bnahill/audiopulse-embedded/(threads)

Thread 11 (2015-10-21):

Noise in analog input conditioning

bnahill, 2015-10-21:
A series of tests showed that a significant amount of input noise is coming from the analog conditioning.

The attached screenshot shows 3 distinct sets of samples. At the top (and consisting of a bunch of tests in slightly varying conditions) you can see normal samples with the microphone connected and isolated from acoustic noise sources. There is noise between 500 and 1000Hz. The series below that removes the microphone and shorts its terminals. Should that noise be at all related to the microphone or acoustic inputs, that noise should be eliminated. It isn't. To further verify, a final series at the bottom shows the result of shorting the terminals at the ADC.

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

Suggest working backwards through the input chain to identify the source of this. If it can't be identified, try to replicate with a different device.

bnahill, 2015-11-03:
The above tests were with a microphone with a low battery. The blue signal below was collected in a relatively noisy environment with a single 30dB channel at 2.2kHz:

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

The green signal highlights a different shortcoming: apparent clipping at moderate levels. The green signal was recorded with a single 60dB channel. The below was captured by an alternate source during the recording

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

The signals never approached bounds of the ADC, yet the distortion is apparent.

bnahill, 2015-11-03:
It looks like there's a decent chance the bug is in the digital parts again, which would be great.
A few options for next time re-visiting this:

1. Use current partial waveform dump capabilities to get a look at the raw data
2. Find a faster way (e.g., interrupt transfers) to dump raw waveforms to debug. This would be awesome for future stuff as well. The USB library must support this by now...
3. Trace the signals over the wire. This is probably the least work.

Thread 12 (2024-02-20):

Device tree for AK4621

xistva02, 2024-02-20:
Hello,

I have a specific question about the incorporation of AK4621. Did you use some kind of device tree configuration for the AK4621 chip? Is it available somewhere?

Thanks.

Matej I.

bnahill, 2024-03-17:
Matej,
I'm sorry it took so long to get back to you. I did not use a device tree for this--the various peripherals used to interact with the AK4621 were hard-coded into the software.
-Ben

xistva02, 2024-03-18:
Hey Ben, thank you for the reply.

I was wondering if you used the codec.cpp file (and other includes) as a machine codec for ALSA? It seems different from the classic audio machine codec driver structure. I found no support for ak4621 in official Linux codecs git: https://github.com/torvalds/linux/tree/master/sound/soc/codecs

My last question is, did you use your codec.cpp file as a machine driver or do you know any source that would provide a driver for ak4621?

Thanks.

Matej I.

bnahill, 2024-03-19:
Matej,
The AK4621 driver used in this project is actually a driver. It's just not one designed for Linux, where the various subcomponents (e.g., SPI and I2S) also need to conform to the Linux APIs for each (and support much broader use and configuration than I needed for this application, e.g., different sample rates and formats). If you're trying to add support to Linux, you have a driver to write. You can use this as a reference for the basics, but it is not a Linux driver.

That said, at the time, the AK4621 was an outstanding codec. I'm not sure what's come out since, but I would still recommend it based on my experience as long as it's still in production.
-Ben

xistva02, 2024-03-19:
Thank you, Ben.

Best regards

Matej I.

Closed 2024-03-19.
