bnahill/audiopulse-embedded/hw/doc/Kinetis K20 QFP64 Mechanical - 98ASS23234W.pdf

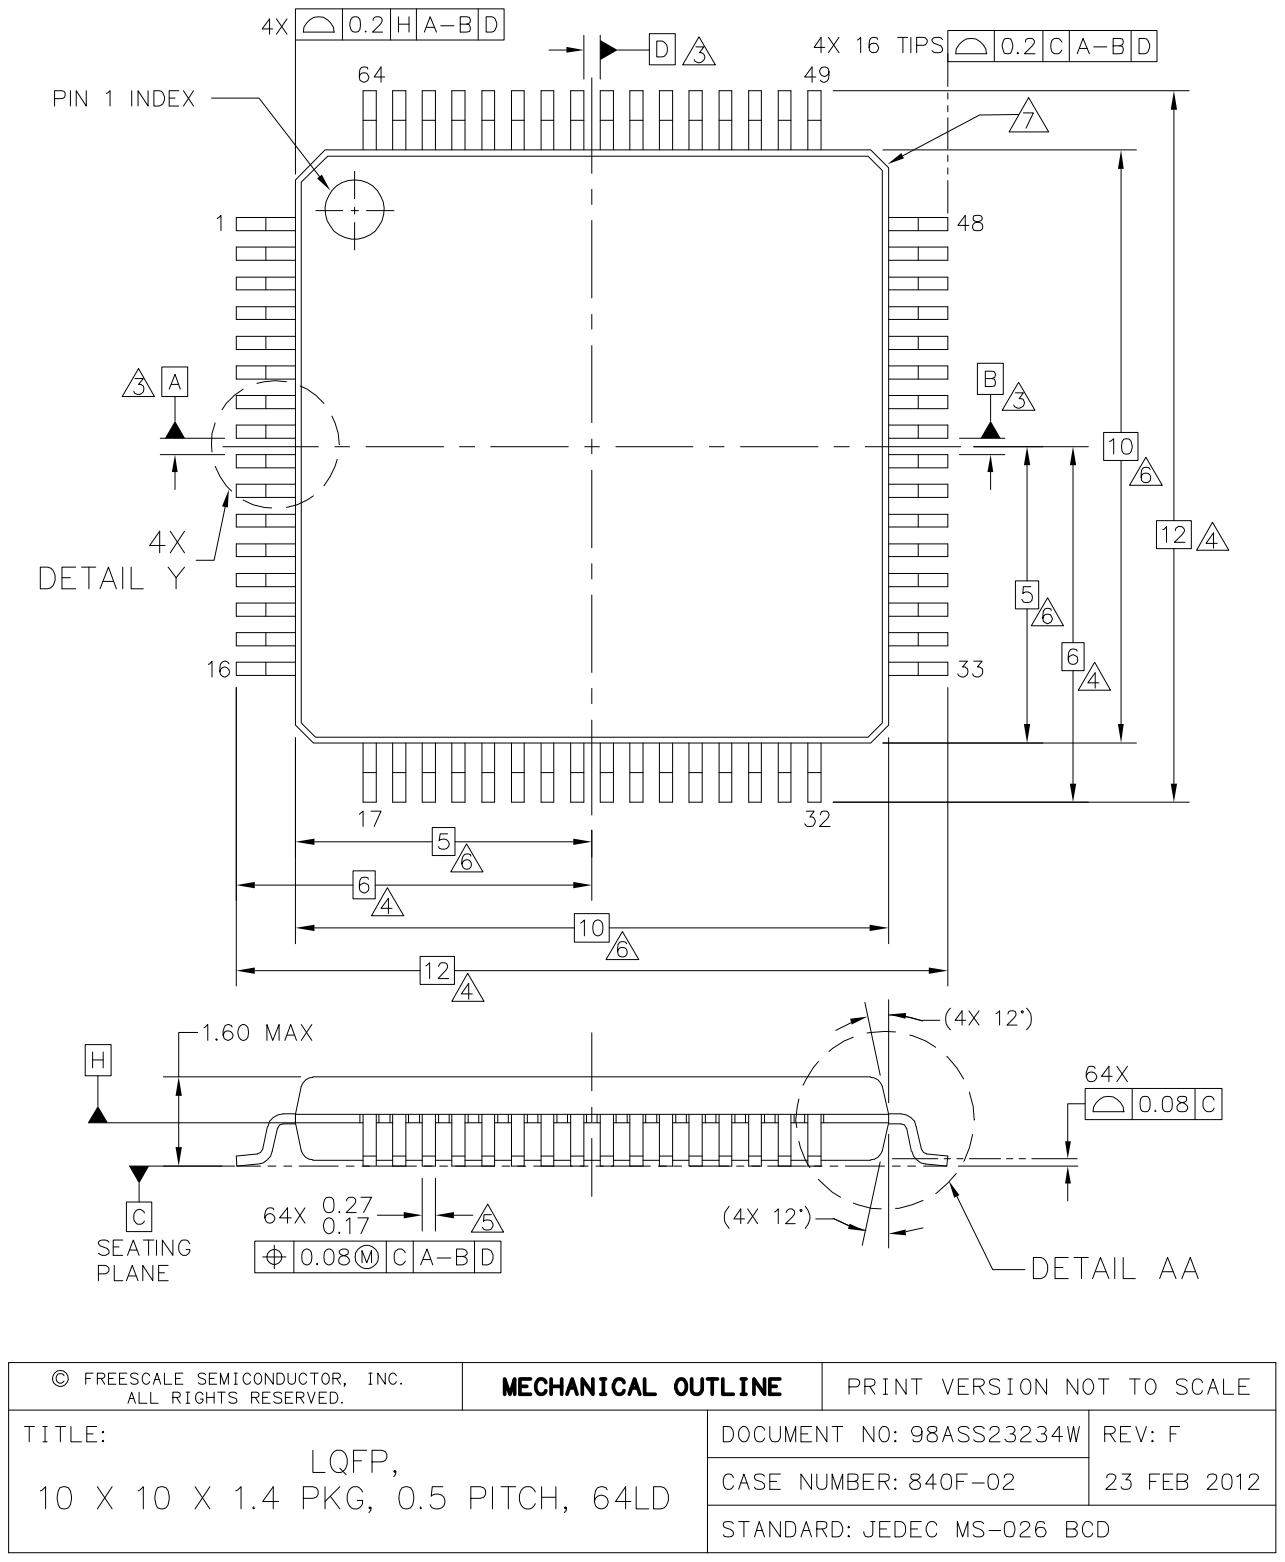
[picture p1: page 1]

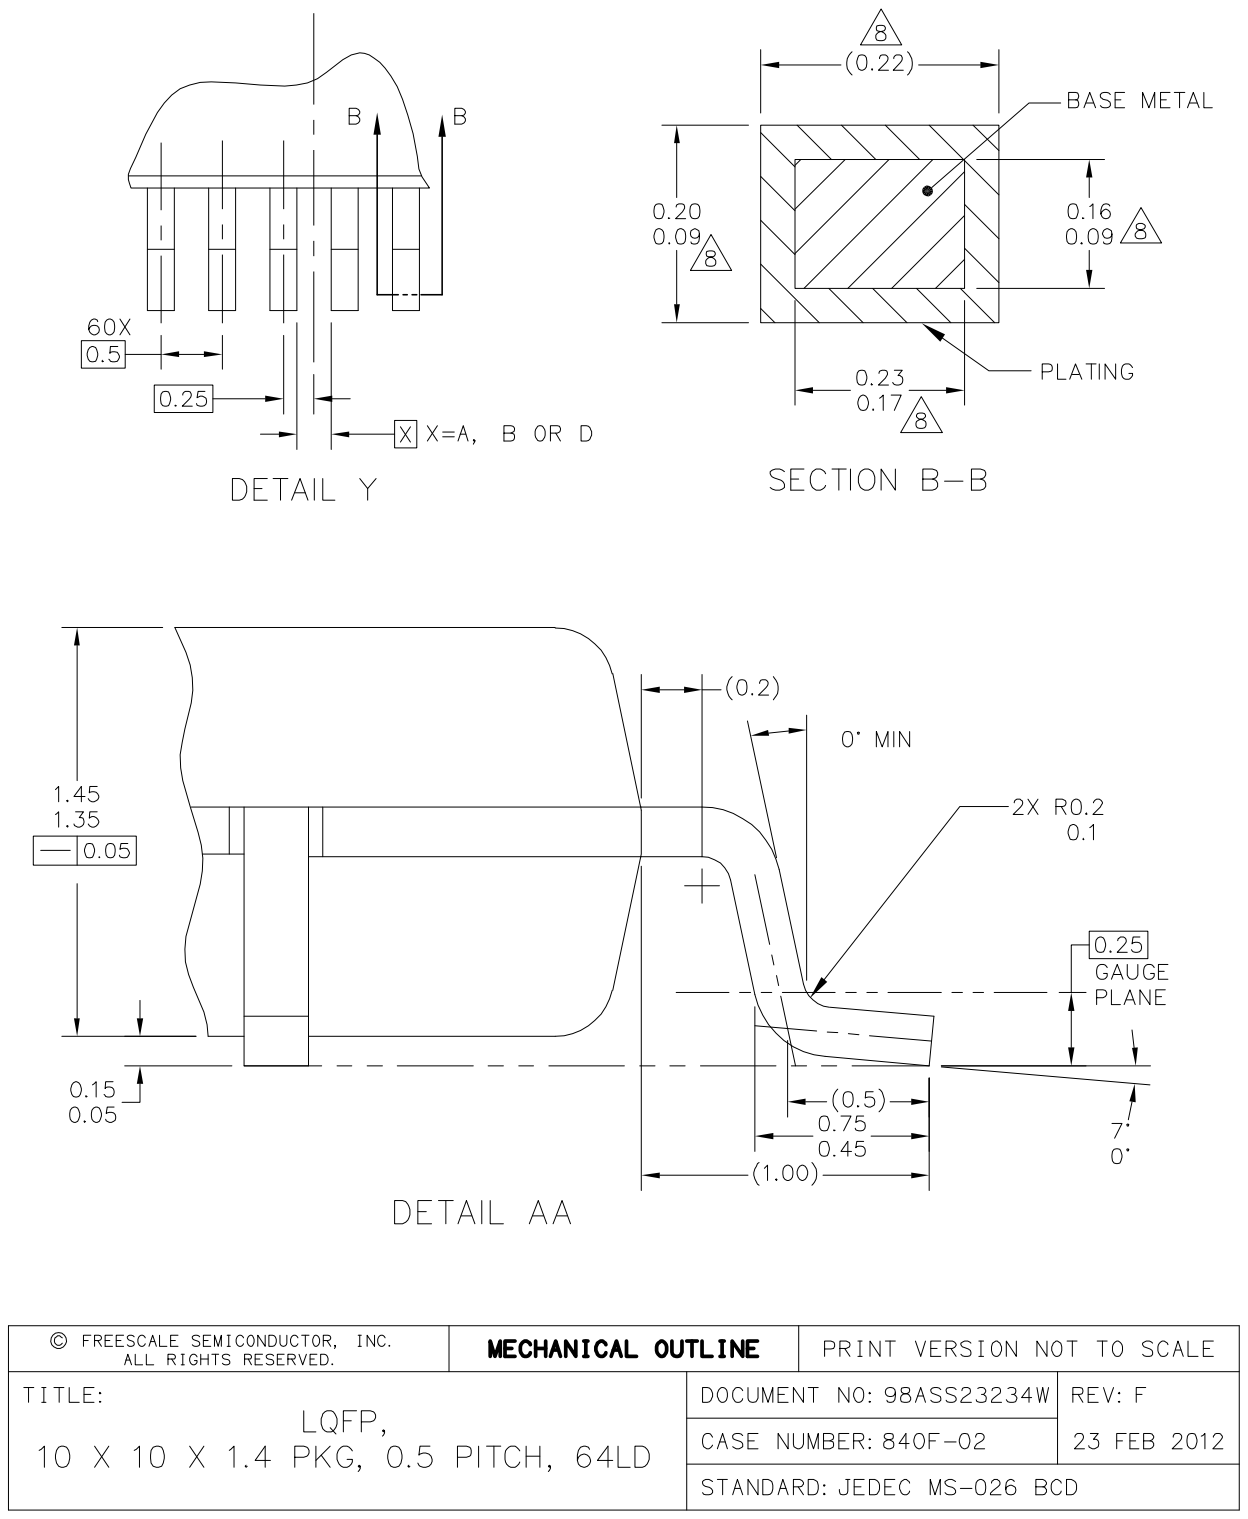
[picture p2: page 2]

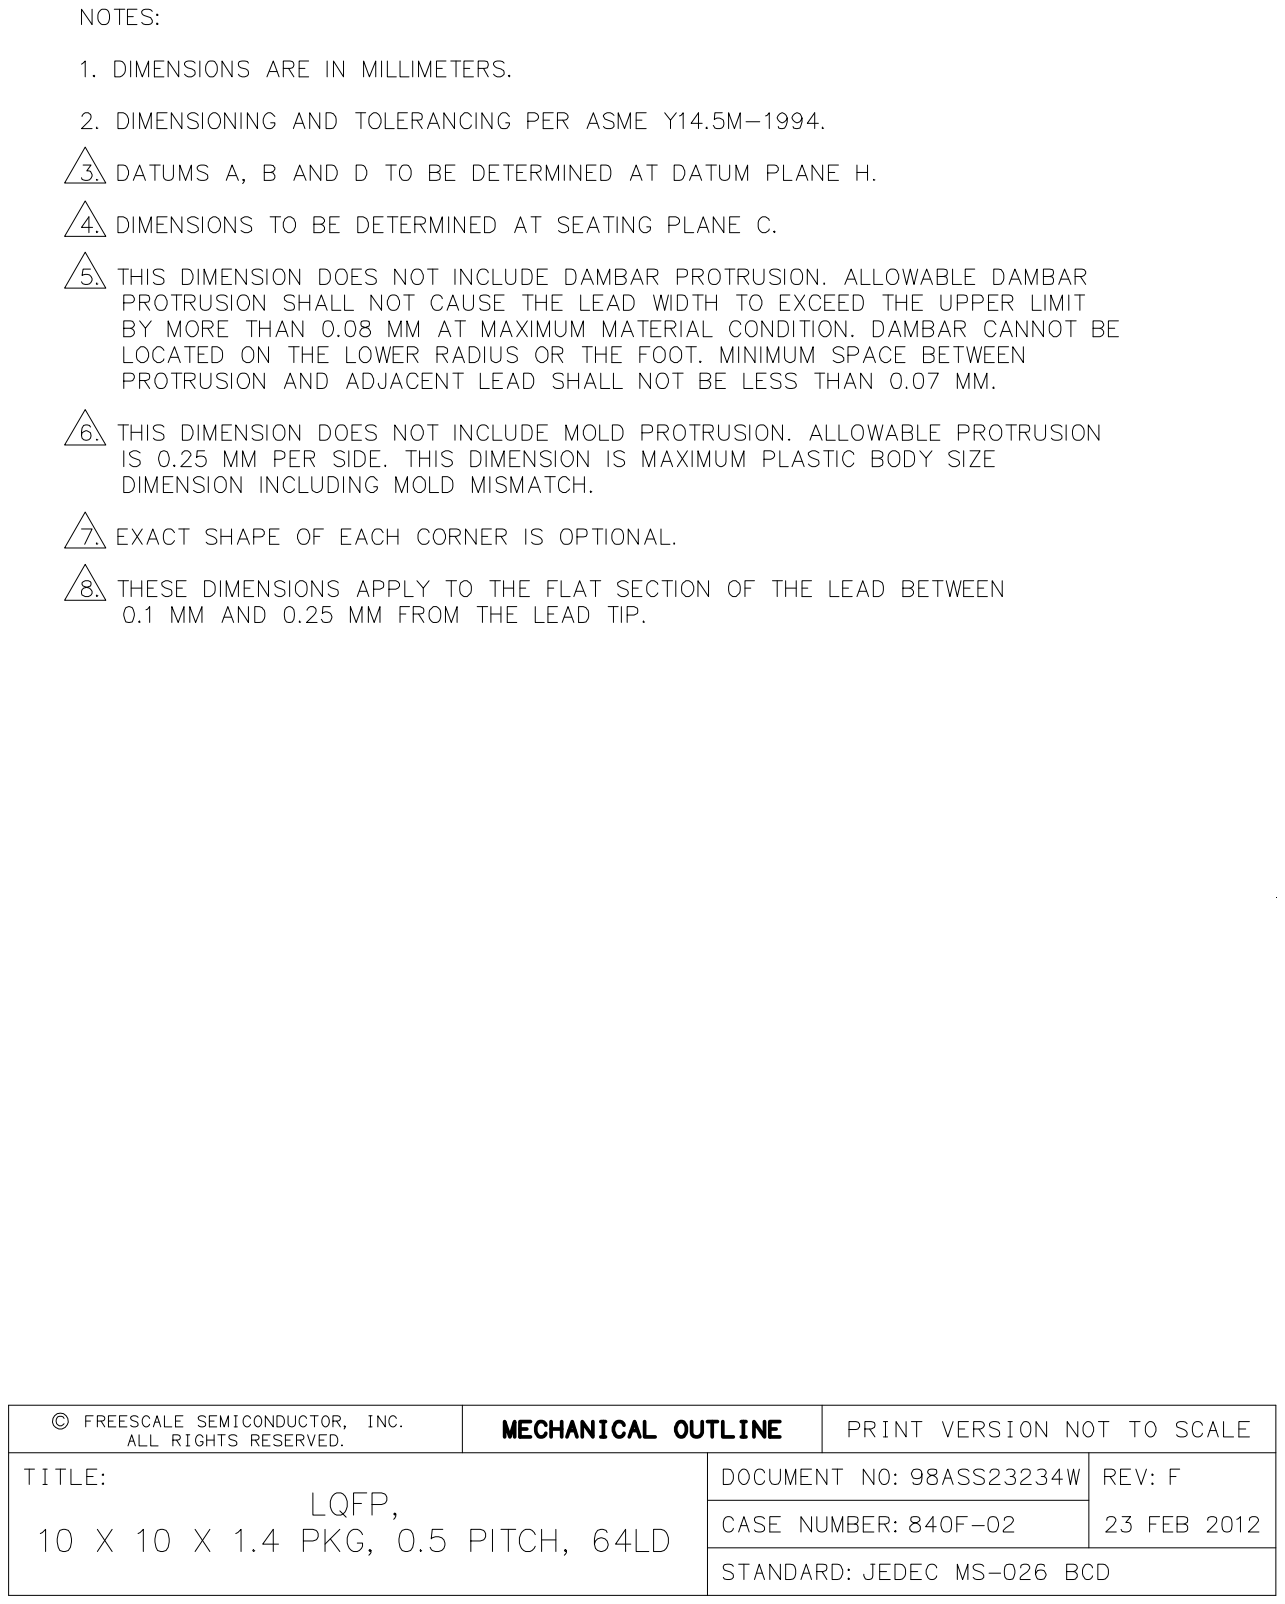
[picture p3: page 3]
