bnahill/audiopulse-embedded/hw/doc/Kinetis K20 QFN32 Mechanical - 98ARE10566D.pdf

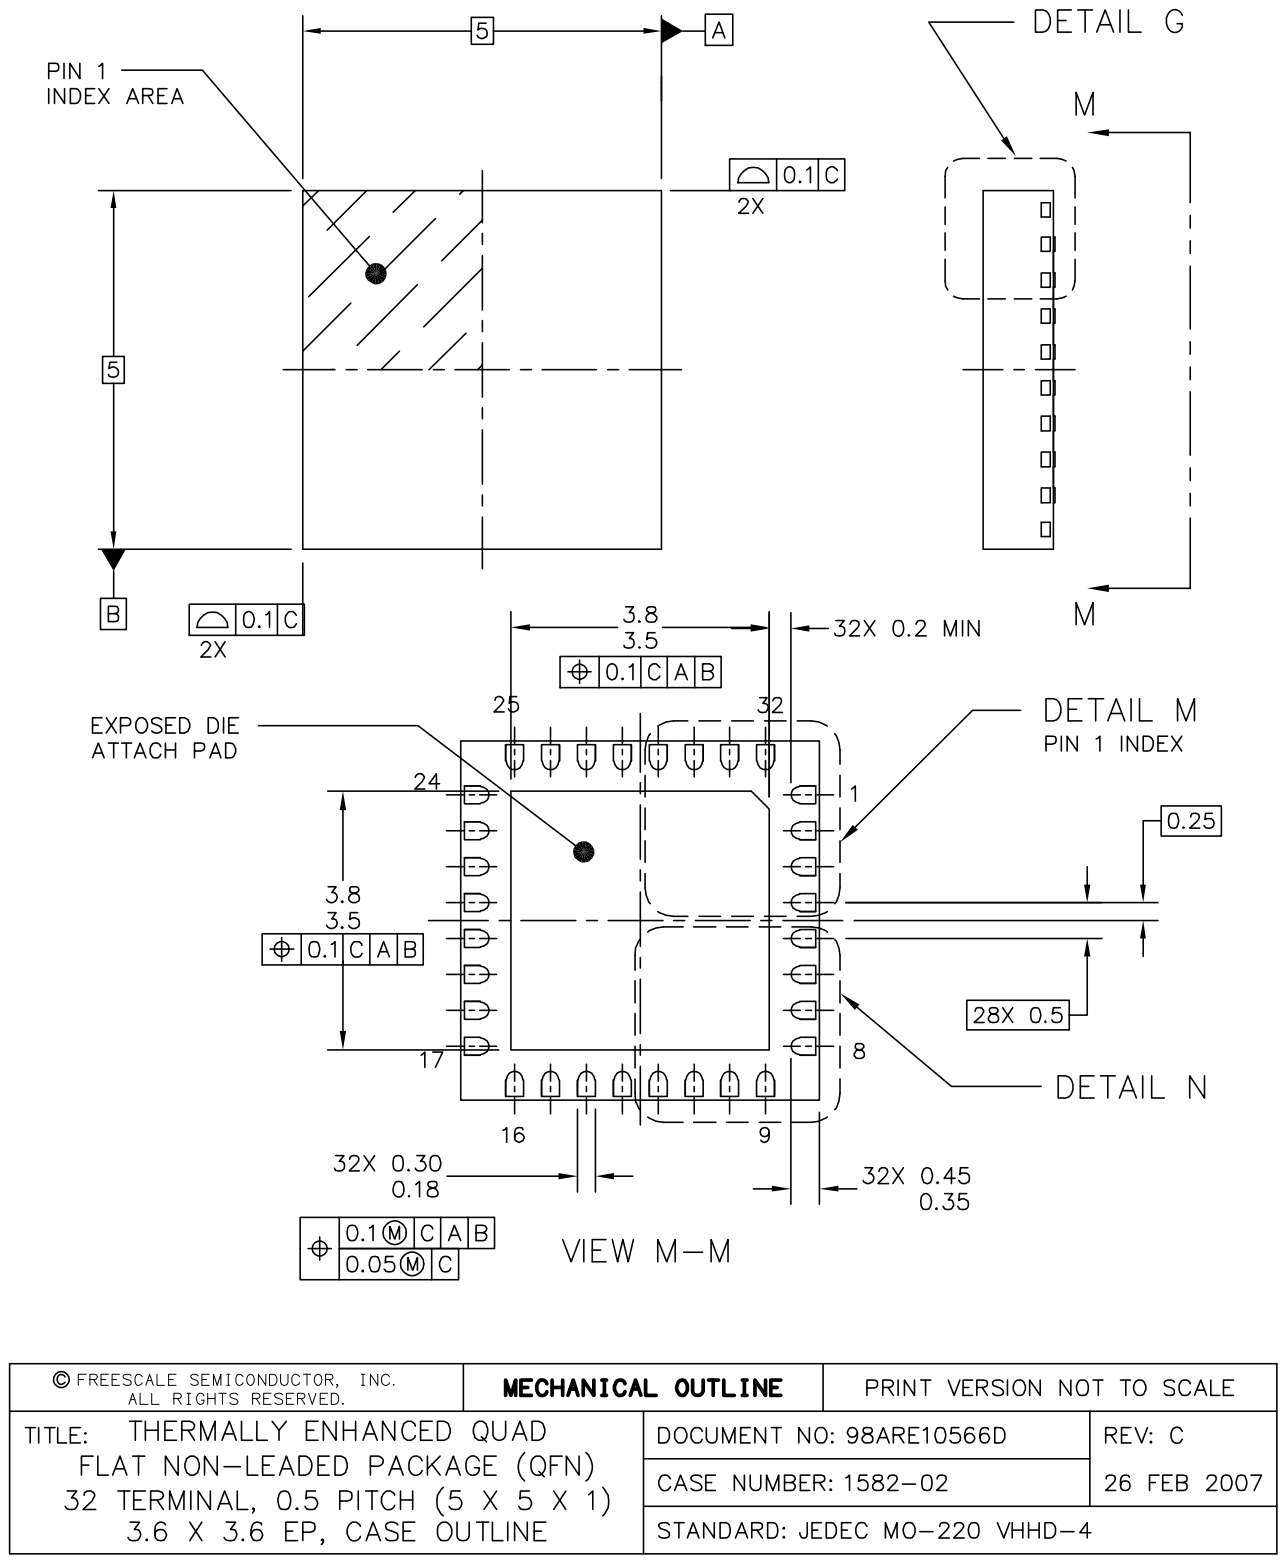
[picture p4: page 1]

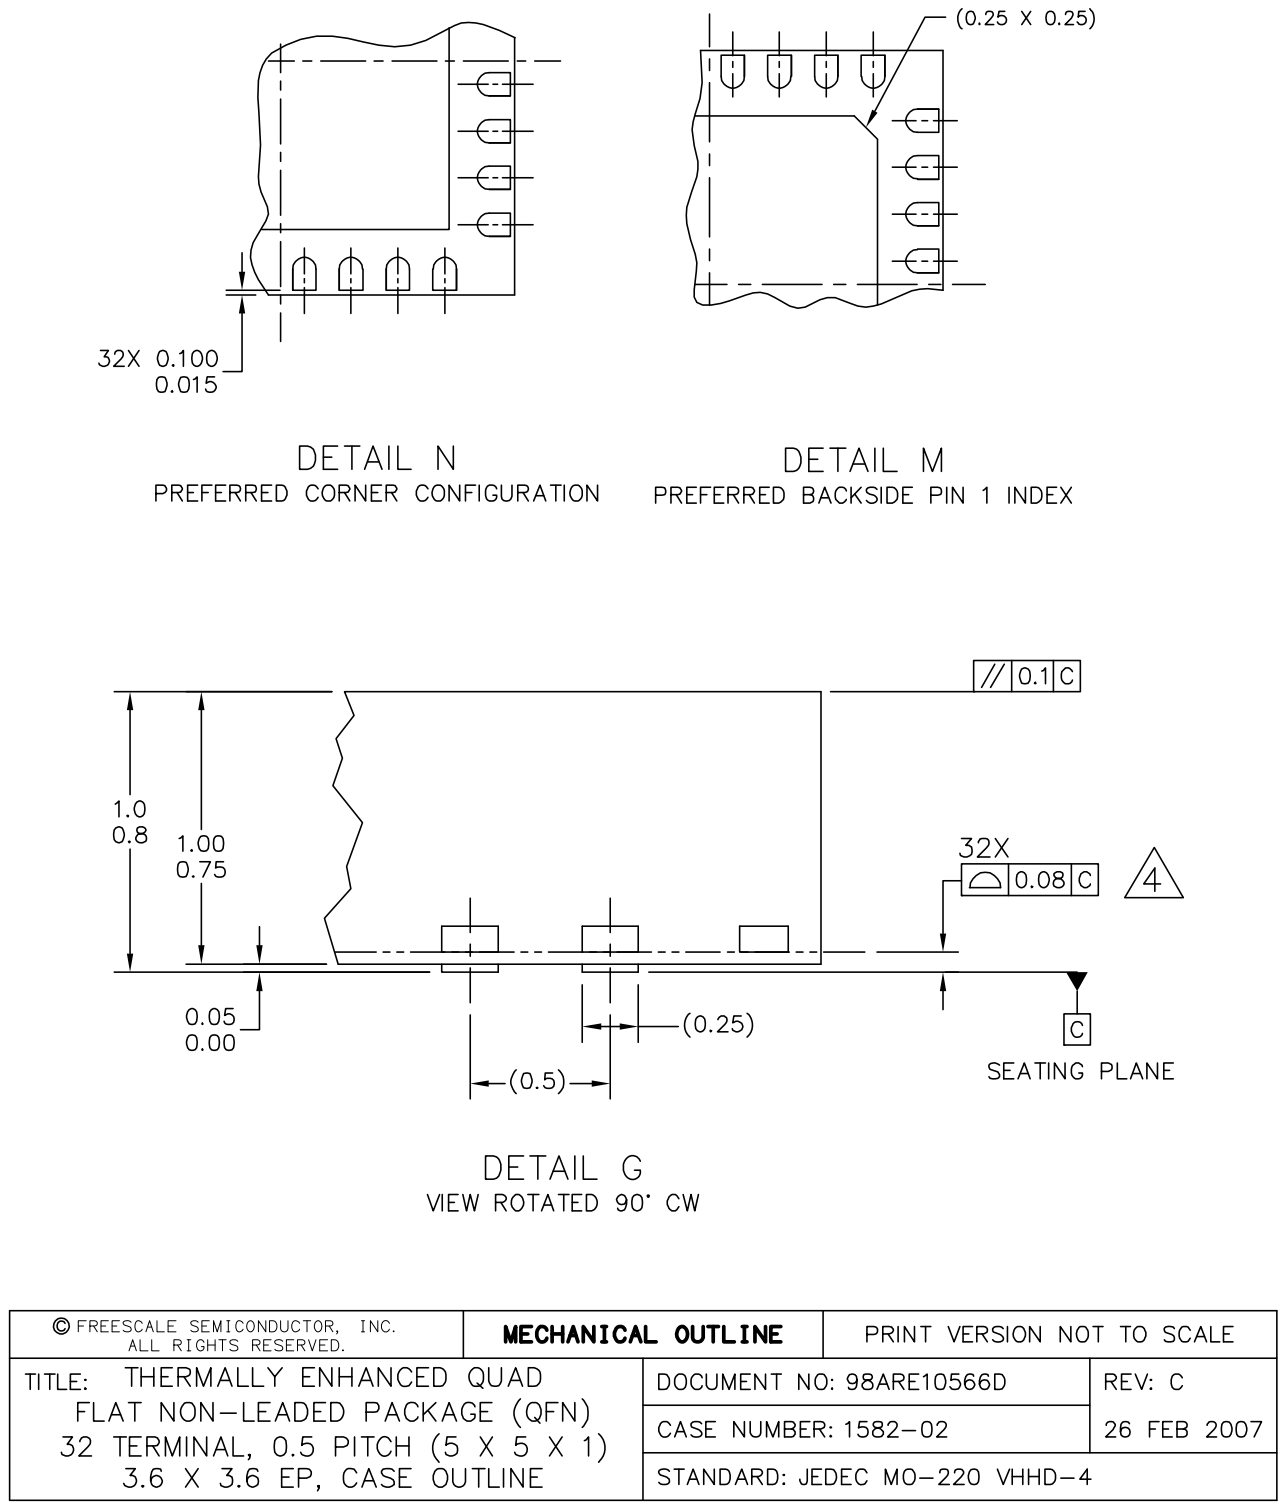
[picture p5: page 2]

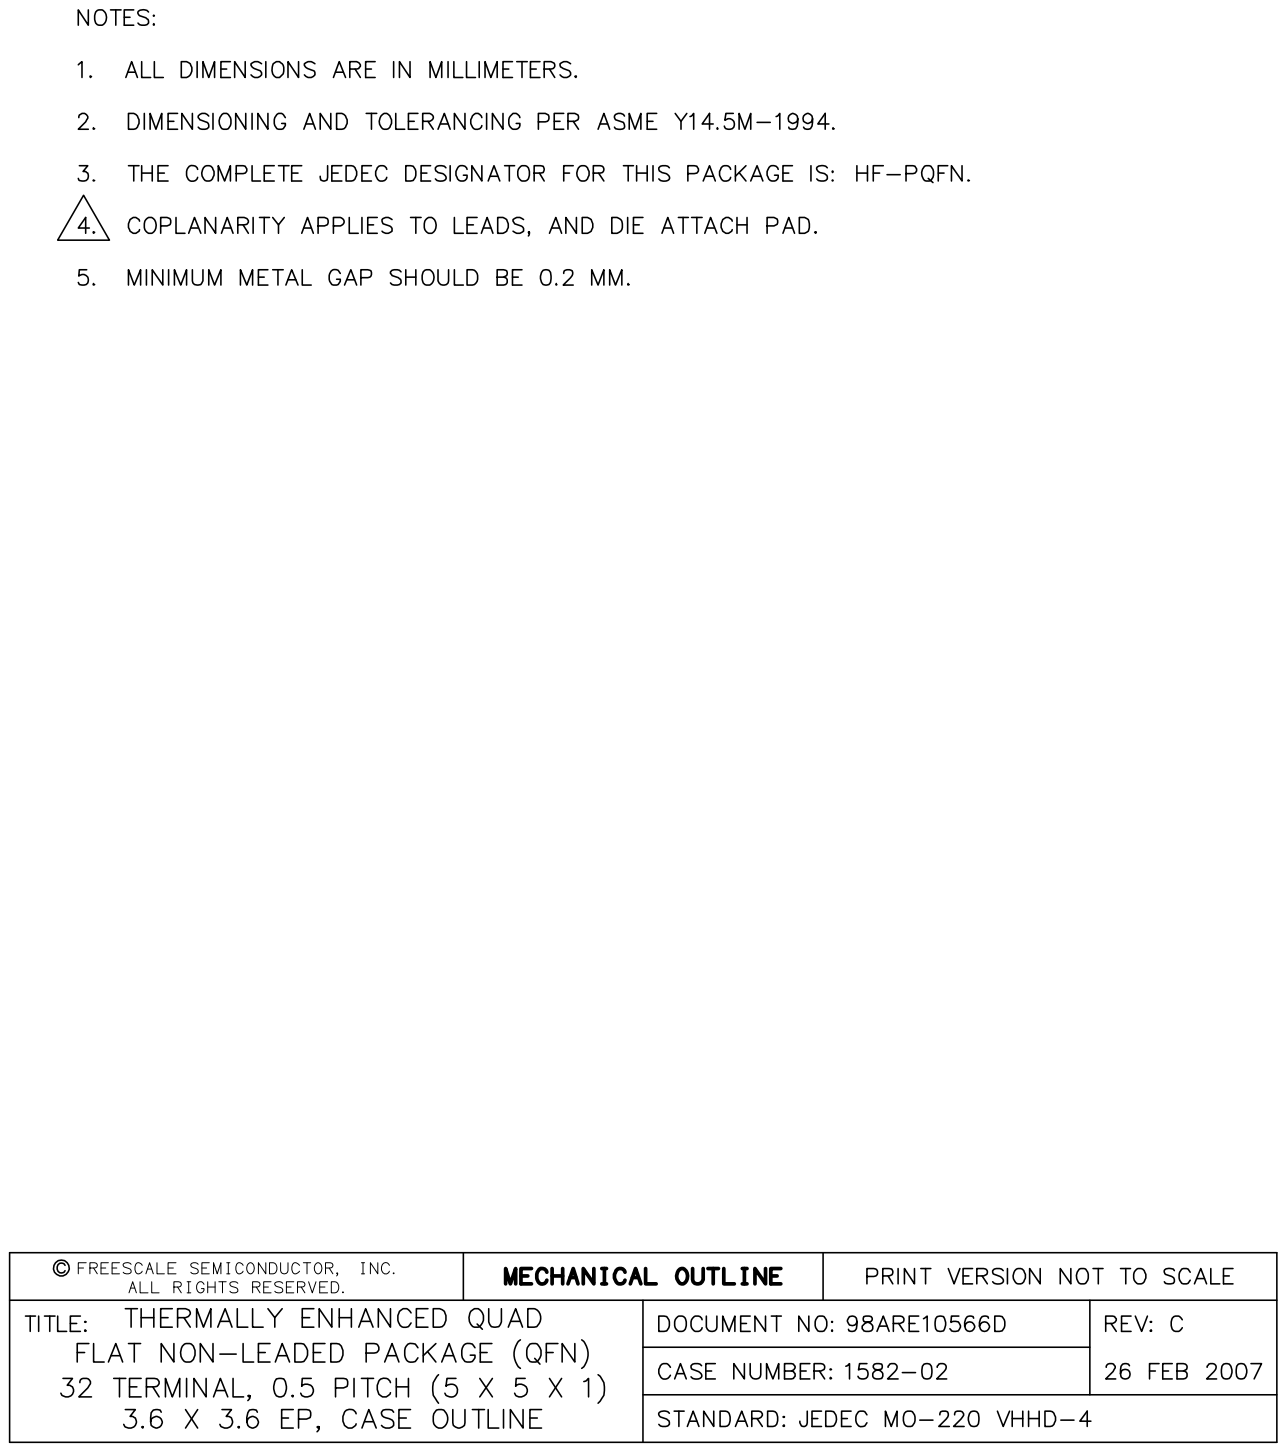
[picture p6: page 3]
