bnahill/audiopulse-embedded/hw/rev2/preamp_sim/preampsimplified.asc

C1: cap; 0.1µ
C2: cap; 10p
C3: cap; 0.1µ
C4: cap; 10µ
C5: cap; 10n
C6: cap; 1n
C7: cap; 33n
C8: cap; 10µ
C9: cap; 2n
C10: cap; 0.01µ
C11: cap; 1µ
C12: cap; 1n
C13: cap; 2n
C14: cap; 100µ; Rser=900m
C15: cap; 10p
C16: cap; 10p
R1: res; 220k
R2: res; 22
R3: res; 22
R4: res; 1k
R5: res; 1k
R6: res; 1.4k
R7: res; 4.53k
R8: res; 220k
R10: res; 5.11k
R11: res; 470
R13: res; 8.87k
R14: res; 10k
R15: res; 26.1k
R17: res; 10k
U1: LTC6242
U2: LTC6242
U4: LTC6242
U5: LTC6241
U6: LTC6242
V1: voltage; 5; Rser=0
V2: voltage; SINE(2 10m 1k 0 0 0 10000); AC 1
V3: voltage; 5; Rser=0
Named nets: 0, 5V, COM, V2, Vout+, Vout-, 7V
;tran 0 0.8 0.05 1u
.noise V(vout+,vout-) V2 dec 100 10 48k
;ac dec 100 1 48k
.MODEL BC550 npn IS =1.8E-14 ISE=5.0E-14 NF =.9955 NE =1.46 BF =400
+BR =35.5 IKF=.14 IKR=.03 ISC=1.72E-13 NC =1.27 NR =1.005 RB =.56 RE =.6
+RC =.25 VAF=80 VAR=12.5 CJE=13E-12 TF =.64E-9 CJC=4E-12 TR =50.72E-9
+VJC=.54 MJC=.33
.param Rnone 1p
.param Rlots 1000Meg
.step dec param VSin 5 10 5
