bnahill/audiopulse-embedded/hw/rev2/audio_iface_rev2.kicad_pcb

## KiCad design hw/rev2/audio_iface_rev2.kicad_pcb (2019-10-14)

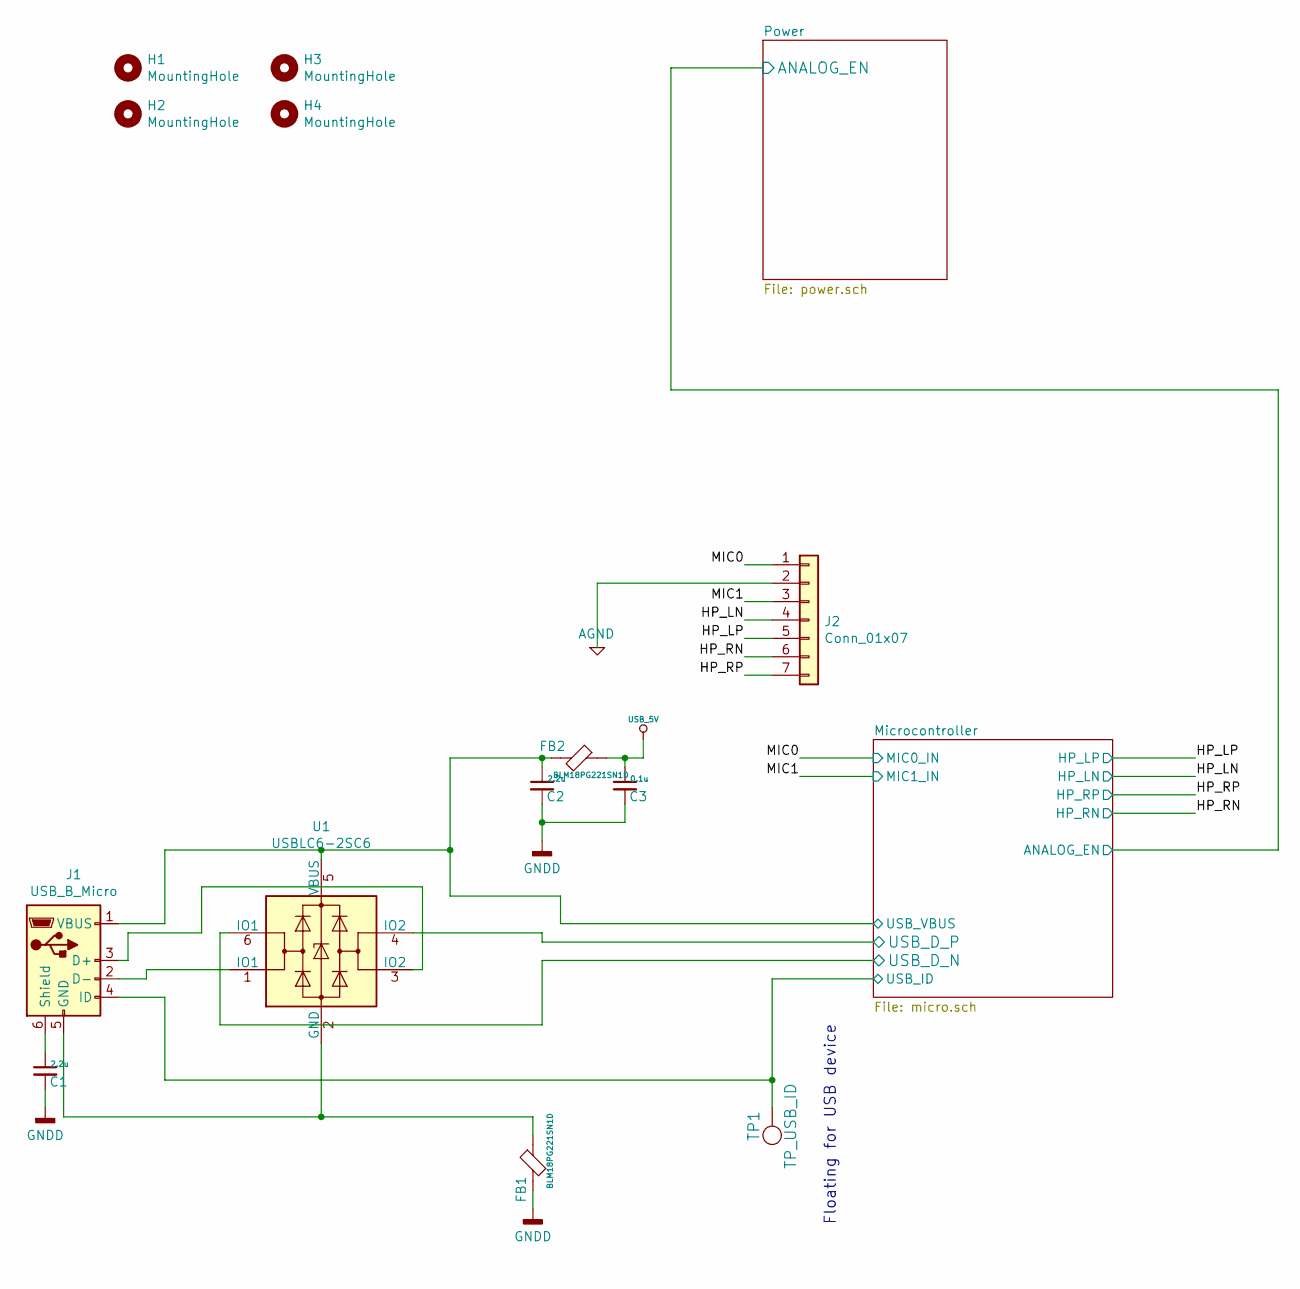
[picture p7: schematic audio_iface_rev2.sch, Android DPOAE Interface]

Parts:
C1, C2: 2.2u; C_0603_1608Metric_Pad1.05x0.95mm_HandSolder
C3: 0.1u; C_0402_1005Metric
FB1, FB2: BLM18PG221SN1D; L_0805_2012Metric_Pad1.15x1.40mm_HandSolder
H1, H2, H3, H4: MountingHole; MountingHole_2.2mm_M2
J1: USB_B_Micro; USB_Micro-B_Molex-105017-0001
J2: Conn_01x07; JST_PH_S7B-PH-K_1x07_P2.00mm_Horizontal
TP1: TP_USB_ID; SolderWirePad_single_1mmDrill
U1: USBLC6-2SC6; SOT-23-6

Connections:
/HP_LN: J2.4; also elsewhere on the board
/HP_LP: J2.5; also elsewhere on the board
/HP_RN: J2.6; also elsewhere on the board
/HP_RP: J2.7; also elsewhere on the board
/MIC0: J2.1; also elsewhere on the board
/MIC1: J2.3; also elsewhere on the board
/Microcontroller/USB_D_N: U1.6 (IO1); also elsewhere on the board
/Microcontroller/USB_D_P: U1.4 (IO2); also elsewhere on the board
/Microcontroller/USB_ID: J1.4 (ID), TP1.1; also elsewhere on the board
/Microcontroller/USB_VBUS: C2.1, FB2.2, J1.1 (VBUS), U1.5 (VBUS); also elsewhere on the board
unnamed: C1.1, J1.6 (Shield)
unnamed: FB1.1, J1.5 (GND), U1.2 (GND)
unnamed: J1.2 (D-), U1.1 (IO1)
unnamed: J1.3 (D+), U1.3 (IO2)
USB_5V: C3.1, FB2.1; also elsewhere on the board

Notes on the sheet:
Floating for USB device

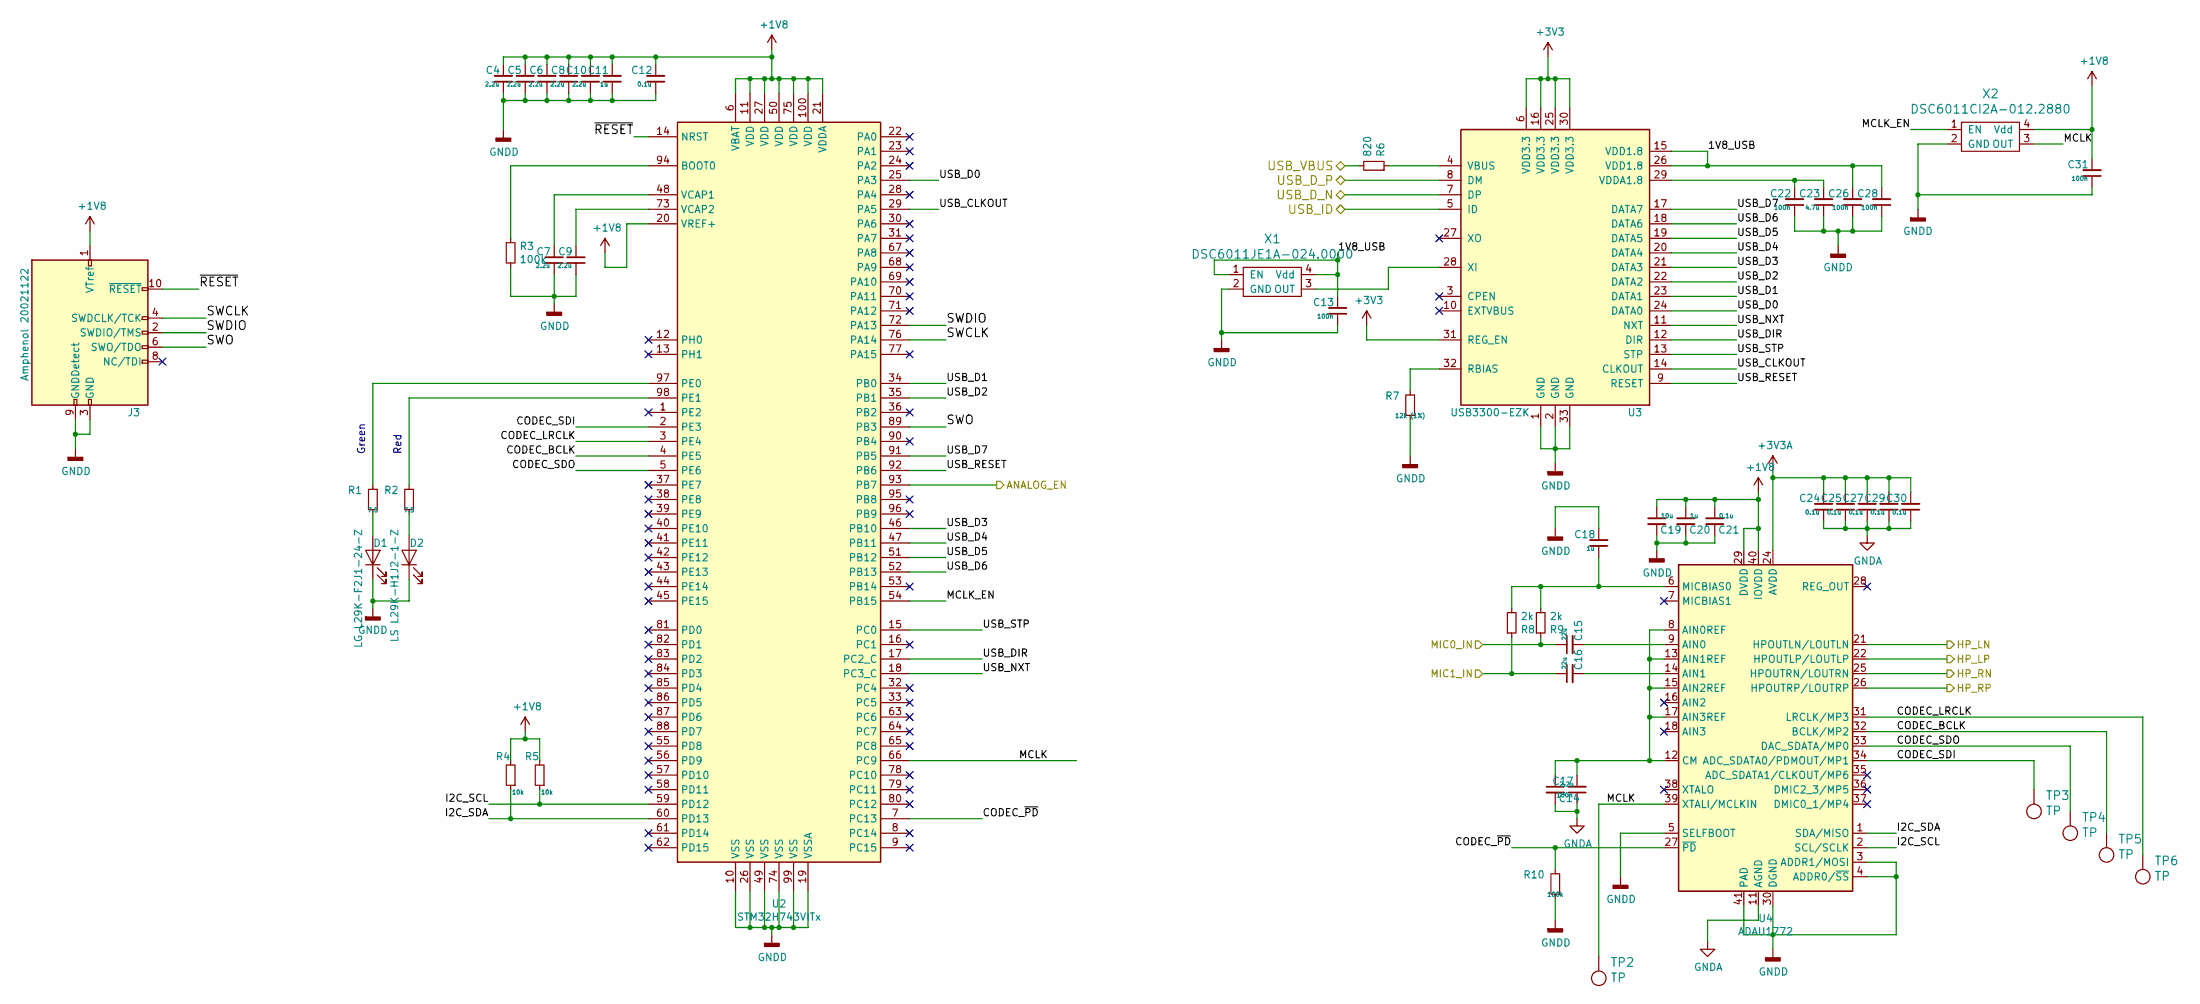
[picture p8: schematic micro.sch, Android DPOAE Interface]

Parts:
C4, C5, C6, C7, C8, C9, C10, C14: 2.2u; C_0603_1608Metric_Pad1.05x0.95mm_HandSolder
C11, C18, C20: 1u; C_0402_1005Metric
C12, C21, C24, C25, C27, C29, C30: 0.1u; C_0402_1005Metric
C13, C17, C22, C26, C28, C31: 100n; C_0402_1005Metric
C15, C16: 22u; C_1210_3225Metric
C19: 10u; C_0805_2012Metric_Pad1.15x1.40mm_HandSolder
C23: 4.7u; C_0805_2012Metric_Pad1.15x1.40mm_HandSolder
D1: LG L29K-F2J1-24-Z; LED_0603_1608Metric_Pad1.05x0.95mm_HandSolder
D2: LS L29K-H1J2-1-Z; LED_0603_1608Metric_Pad1.05x0.95mm_HandSolder
J3: Amphenol 20021122; PinHeader_2x05_P1.27mm_Vertical
R1, R2: 7.5; R_0402_1005Metric
R3, R10: 100k; R_0402_1005Metric
R4, R5: 10k; R_0402_1005Metric
R6: 820; R_0402_1005Metric
R7: 12k (1%); R_0402_1005Metric
R8, R9: 2k; R_0402_1005Metric
TP2, TP3, TP4, TP5, TP6: TP; SolderWirePad_single_1mmDrill
U2: STM32H743VITx; LQFP-100_14x14mm_P0.5mm
U3: USB3300-EZK; QFN-32-1EP_5x5mm_P0.5mm_EP3.1x3.1mm_ThermalVias
U4: ADAU1772; QFN-40-1EP_6x6mm_P0.5mm_EP4.6x4.6mm_ThermalVias
X1: DSC6011JE1A-024.0000; Oscillator_SMD_SeikoEpson_SG210-4Pin_2.5x2.0mm_HandSoldering
X2: DSC6011CI2A-012.2880; Oscillator_SMD_EuroQuartz_XO32-4Pin_3.2x2.5mm_HandSoldering

Connections:
+1V8: C4.2, C5.2, C6.2, C8.2, C10.2, C11.2, C12.2, C19.1, C20.1, C21.1, C31.2, J3.1 (VTref), R4.2, R5.2, U2.6 (VBAT), U2.11 (VDD), U2.20 (VREF+), U2.21 (VDDA), U2.27 (VDD), U2.50 (VDD), U2.75 (VDD), U2.100 (VDD), U4.29 (DVDD), U4.40 (IOVDD), X2.4 (Vdd); also elsewhere on the board
+3V3: U3.6 (VDD3.3), U3.16 (VDD3.3), U3.25 (VDD3.3), U3.30 (VDD3.3), U3.31 (REG_EN); also elsewhere on the board
+3V3A: C24.2, C25.2, C27.2, C29.2, C30.2, U4.10 (AVDD), U4.19 (AVDD), U4.24 (AVDD); also elsewhere on the board
/HP_LN: U4.21 (HPOUTLN/LOUTLN); also elsewhere on the board
/HP_LP: U4.22 (HPOUTLP/LOUTLP); also elsewhere on the board
/HP_RN: U4.25 (HPOUTRN/LOUTRN); also elsewhere on the board
/HP_RP: U4.26 (HPOUTRP/LOUTRP); also elsewhere on the board
/MIC0: C15.1, R9.1; also elsewhere on the board
/MIC1: C16.1, R8.1; also elsewhere on the board
/Microcontroller/1V8_USB: C13.2, C26.2, C28.2, U3.15 (VDD1.8), U3.26 (VDD1.8), X1.1 (EN), X1.4 (Vdd)
/Microcontroller/ANALOG_EN: U2.93 (PB7); also elsewhere on the board
/Microcontroller/CODEC_BCLK: TP5.1, U2.4 (PE5), U4.32 (BCLK/MP2)
/Microcontroller/CODEC_LRCLK: TP6.1, U2.3 (PE4), U4.31 (LRCLK/MP3)
/Microcontroller/CODEC_SDI: TP3.1, U2.2 (PE3), U4.34 (ADC_SDATA0/PDMOUT/MP1)
/Microcontroller/CODEC_SDO: TP4.1, U2.5 (PE6), U4.33 (DAC_SDATA/MP0)
/Microcontroller/CODEC_~PD: R10.2, U2.7 (PC13), U4.27 (~PD)
/Microcontroller/I2C_SCL: R5.1, U2.59 (PD12), U4.2 (SCL/SCLK)
/Microcontroller/I2C_SDA: R4.1, U2.60 (PD13), U4.1 (SDA/MISO)
/Microcontroller/MCLK: TP2.1, U2.66 (PC9), U4.39 (XTALI/MCLKIN), X2.3 (OUT)
/Microcontroller/MCLK_EN: U2.54 (PB15), X2.1 (EN)
/Microcontroller/SWCLK: J3.4 (SWDCLK/TCK), U2.76 (PA14)
/Microcontroller/SWDIO: J3.2 (SWDIO/TMS), U2.72 (PA13)
/Microcontroller/SWO: J3.6 (SWO/TDO), U2.89 (PB3)
/Microcontroller/USB_CLKOUT: U2.29 (PA5), U3.14 (CLKOUT)
/Microcontroller/USB_D0: U2.25 (PA3), U3.24 (DATA0)
/Microcontroller/USB_D1: U2.34 (PB0), U3.23 (DATA1)
/Microcontroller/USB_D2: U2.35 (PB1), U3.22 (DATA2)
/Microcontroller/USB_D3: U2.46 (PB10), U3.21 (DATA3)
/Microcontroller/USB_D4: U2.47 (PB11), U3.20 (DATA4)
/Microcontroller/USB_D5: U2.51 (PB12), U3.19 (DATA5)
/Microcontroller/USB_D6: U2.52 (PB13), U3.18 (DATA6)
/Microcontroller/USB_D7: U2.91 (PB5), U3.17 (DATA7)
/Microcontroller/USB_DIR: U2.17 (PC2_C), U3.12 (DIR)
/Microcontroller/USB_D_N: U3.7 (DP); also elsewhere on the board
/Microcontroller/USB_D_P: U3.8 (DM); also elsewhere on the board
/Microcontroller/USB_ID: U3.5 (ID); also elsewhere on the board
/Microcontroller/USB_NXT: U2.18 (PC3_C), U3.11 (NXT)
/Microcontroller/USB_RESET: U2.92 (PB6), U3.9 (RESET)
/Microcontroller/USB_STP: U2.15 (PC0), U3.13 (STP)
/Microcontroller/USB_VBUS: R6.2; also elsewhere on the board
/Microcontroller/~RESET: J3.10 (~RESET~), U2.14 (NRST)
unnamed: C7.2, U2.48 (VCAP1)
unnamed: C9.2, U2.73 (VCAP2)
unnamed: C14.1, C17.2, U4.8 (AIN0REF), U4.12 (CM), U4.13 (AIN1REF), U4.15 (AIN2REF), U4.17 (AIN3REF)
unnamed: C15.2, U4.9 (AIN0)
unnamed: C16.2, U4.14 (AIN1)
unnamed: C18.1, R8.2, R9.2, U4.6 (MICBIAS0)
unnamed: C22.2, C23.2, U3.29 (VDDA1.8)
unnamed: D1.2 (A), R1.1
unnamed: D2.2 (A), R2.1
unnamed: R1.2, U2.97 (PE0)
unnamed: R2.2, U2.98 (PE1)
unnamed: R3.1, U2.94 (BOOT0)
unnamed: R6.1, U3.4 (VBUS)
unnamed: R7.2, U3.32 (RBIAS)
unnamed: U3.28 (XI), X1.3 (OUT)

Notes on the sheet:
Green
Red

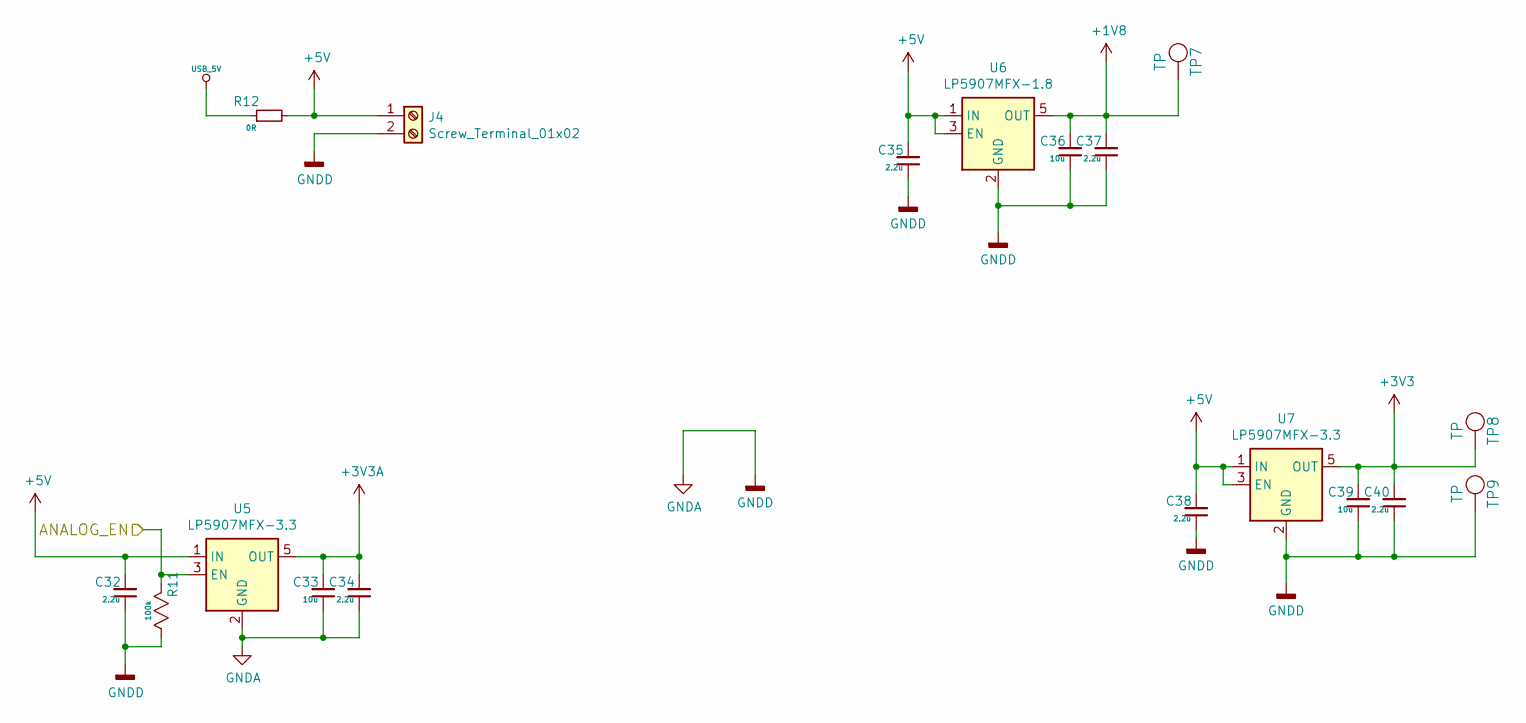
[picture p9: schematic power.sch]

Parts:
C32, C34, C35, C37, C38, C40: 2.2u; C_0603_1608Metric_Pad1.05x0.95mm_HandSolder
C33, C36, C39: 10u; C_0805_2012Metric_Pad1.15x1.40mm_HandSolder
J4: Screw_Terminal_01x02; PinHeader_1x02_P2.54mm_Vertical
R11: 100k; R_0402_1005Metric
R12: 0R; R_0402_1005Metric
TP7, TP8, TP9: TP; SolderWirePad_single_1mmDrill
U5, U7: LP5907MFX-3.3; SOT-23-5
U6: LP5907MFX-1.8; SOT-23-5

Connections:
+1V8: C36.2, C37.2, TP7.1, U6.5 (OUT); also elsewhere on the board
+3V3: C39.2, C40.2, TP8.1, U7.5 (OUT); also elsewhere on the board
+3V3A: C33.2, C34.2, U5.5 (OUT); also elsewhere on the board
+5V: C32.2, C35.2, C38.2, J4.1, R12.2, U5.1 (IN), U6.1 (IN), U6.3 (EN), U7.1 (IN), U7.3 (EN)
/Microcontroller/ANALOG_EN: R11.2, U5.3 (EN); also elsewhere on the board
USB_5V: R12.1; also elsewhere on the board

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
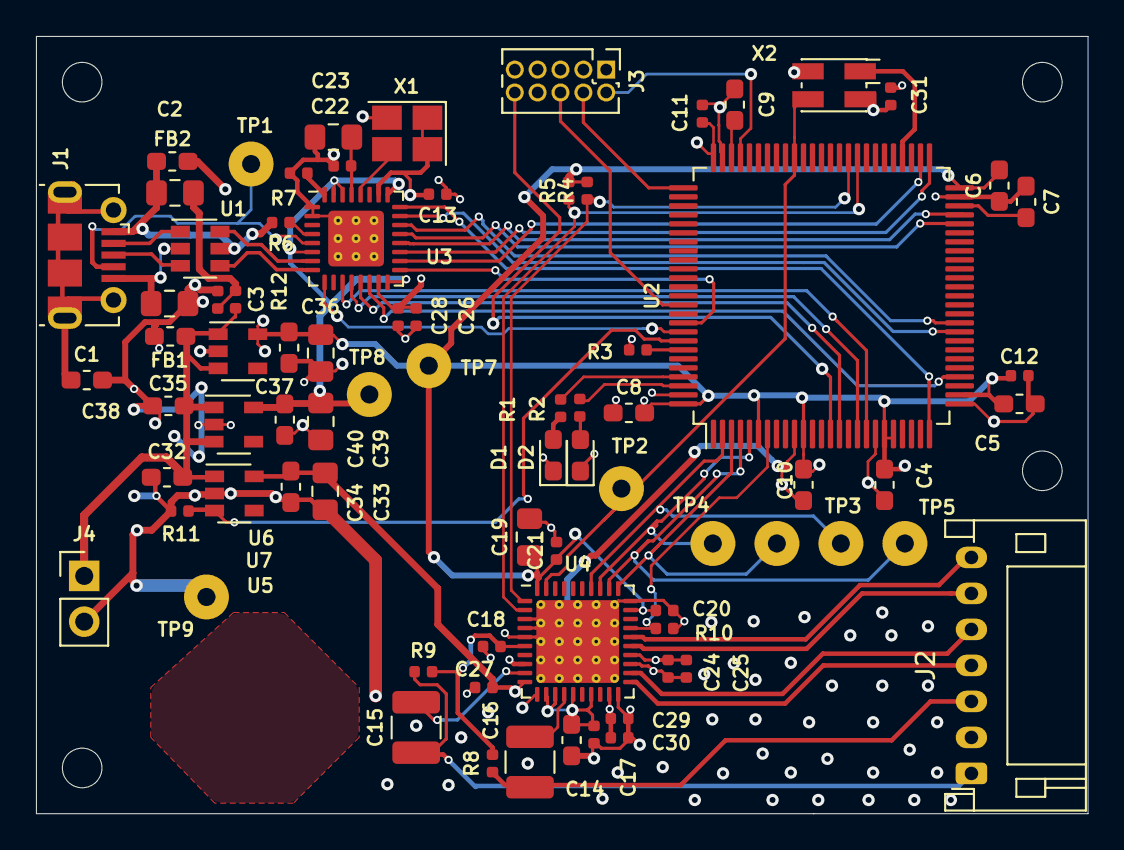
[picture p10: board audio_iface_rev2.kicad_pcb from above]

Board: 4 copper layers, 58.4 x 43.2 mm, 82 parts (0 on the bottom side), 63 nets.
