bnahill/audiopulse-embedded/hw/sma_adapter/sma_adapter.kicad_pcb

## KiCad design hw/sma_adapter/sma_adapter.kicad_pcb (2015-05-13)

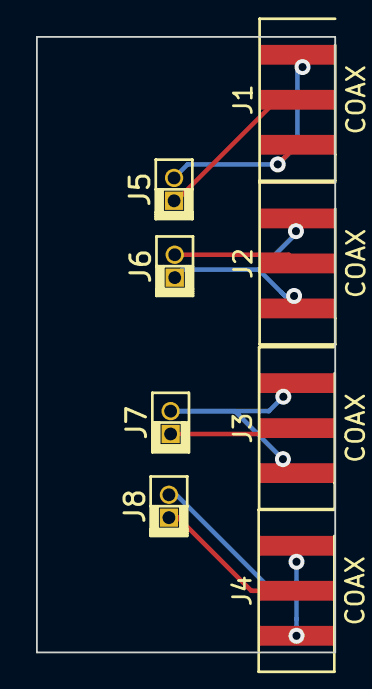
[picture p11: board sma_adapter.kicad_pcb from above]

Board: 2 copper layers, 16.6 x 34.2 mm, 8 parts (0 on the bottom side), 8 nets.

Parts:
J1, J2, J3, J4: COAX; SMA_EDGE
J5, J6, J7, J8: CONN_2; HDR_2X1_50MIL

Connections:
unnamed: J2.2, J6.1
unnamed: J3.1, J7.1
unnamed: J3.2, J7.2
unnamed: J4.1, J8.1
unnamed: J4.2, J8.2
unnamed: J1.2, J5.2
unnamed: J2.1, J6.2
unnamed: J1.1, J5.1
