bnahill/audiopulse-embedded/hw/rev1/audio_iface_rev1.kicad_pcb

## KiCad design hw/rev1/audio_iface_rev1.kicad_pcb (2013-10-15, an earlier design)

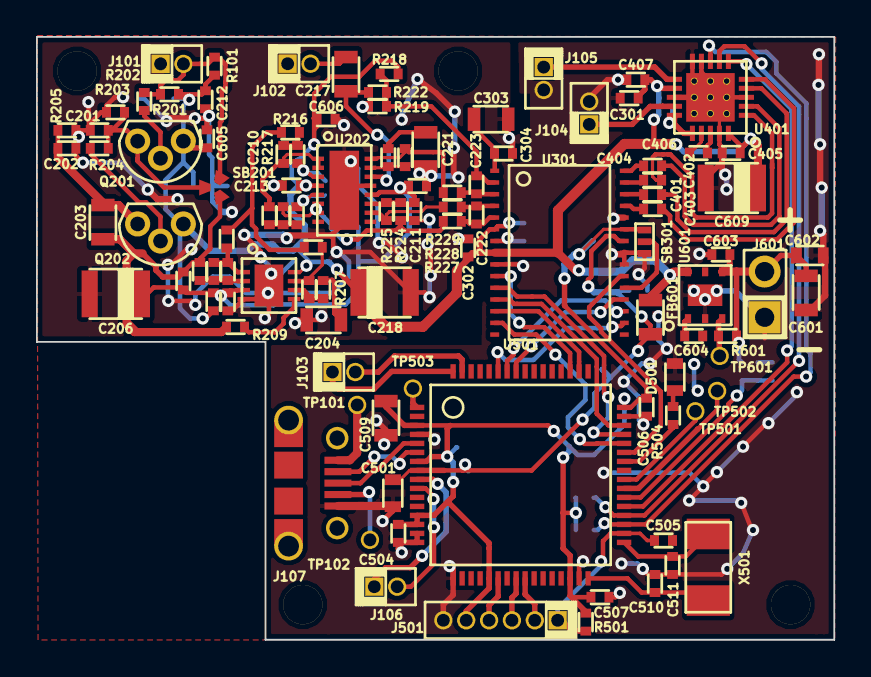
[picture p12: board audio_iface_rev1.kicad_pcb from above]

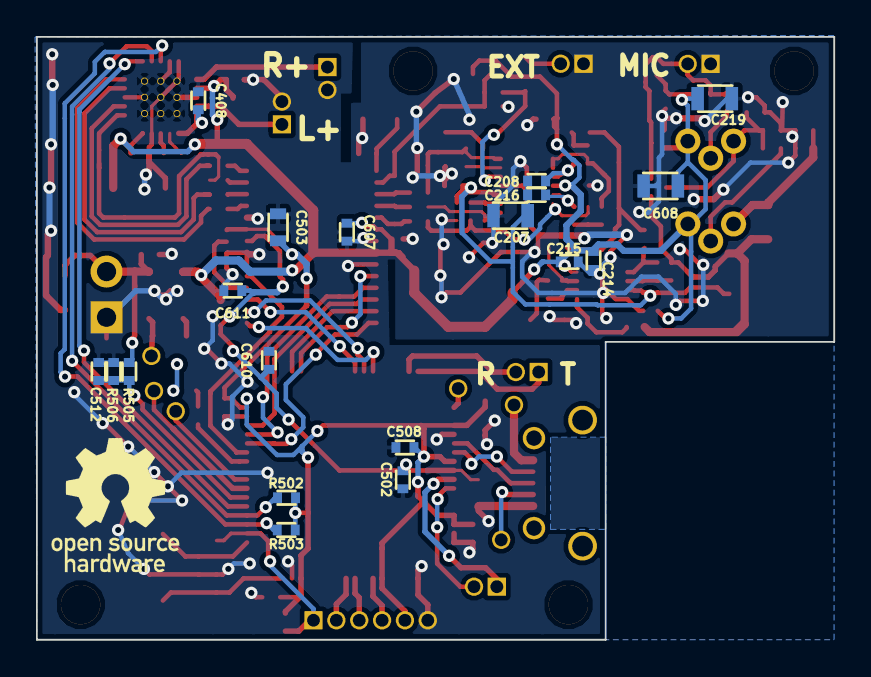
[picture p13: board audio_iface_rev1.kicad_pcb from below]

Board: 2 copper layers, 44.3 x 33.5 mm, 128 parts (20 on the bottom side), 85 nets.

Parts:
C201, C208, C216: 1n; SMD0402
C202, C401, C402, C403, C404: 0.47u; SMD0402
C203, C207: 10u 4V; SMD0805
C204, C217, C219, C221, C608: 10u 6.3V; SMD0805
C205, C210: 2n; SMD0402
C206: 100u 4V; SMD1411_POL
C209, C301, C405, C406, C407, C408, C504, C506, C512: 1u; SMD0402
C211, C302, C304, C502, C505, C507, C508: 0.1u; SMD0402
C212, C213, C606, C607, C610, C611: 0.1u 6.3V; SMD0402
C214, C215: 1u 6.3V; SMD0402
C218, C609: 100u 6.3V; SMD1411_POL
C220: 33n; SMD0402
C222, C223: 10n; SMD0402
C303: 10u; SMD0805
C501, C503: 2.2u; SMD0603
C509: 10n; SMD0805
C510, C511: CAP; SMD0402
C601: 10u 16V; SMD0805
C602: 2.2u 16V; SMD0603
C603, C604: 10n 16V; SMD0402
C605: 10n 6.3V; SMD0402
D501: LED; SMD0603
FB601: FB; SMD0805
J101, J102, J103, J104, J105, J106: CONN_2; HDR_2X1_50MIL
J107: USBMICROCONN; FCI_10118194
J501: CONN_6; HDR_6X1_50MIL
J601: CONN_2; HDR_2X1_100MIL
Q201, Q202: BC550; TO92-STRAIGHT-CBE
R101: 3.9k (1%); SMD0402
R201: 3.9k; SMD0402
R202, R204, R209, R213: 0R; SMD0402
R203: 5k; SMD0402
R205: 200; SMD0402
R206, R222: 250k; SMD0402
R207: 100 (1%); SMD0402
R208: 90 (1%); SMD0402
R210, R211: 5k (1%); SMD0402
R212, R504: RES; SMD0402
R214, R215: 1k (1%); SMD0402
R216: 8.87k (1%); SMD0402
R217: 26.1k (1%); SMD0402
R218, R219: 1k; SMD0402
R220: 1.4k (1%); SMD0402
R221: 4.53k (1%); SMD0402
R223, R226: 220 (1%); SMD0402
R224, R225: 10k (1%); SMD0402
R227, R228, R229: 22; SMD0402
R501, R502, R503: 10k; SMD0402
R505: 330k; SMD0402
R506: 100k; SMD0402
R601: 22k; SMD0402
SB201: SB_3
SB301: SB_2-1
SCREW_HOLE_2-56, SCREW_HOLE_2-56#2, SCREW_HOLE_2-56#3, SCREW_HOLE_2-56#4: VAL**; SCREW_HOLE_2-56
TP101: TP_VUSB; TP_HOLE
TP102: TP_USB_ID; TP_HOLE
TP501: TP_PTB3; TP_HOLE
TP502: TP_PTB16; TP_HOLE
TP503: TP_PTE0; TP_HOLE
TP601: TP_5VEN; TP_HOLE
U201: LT6201; LT_DFN8_DUAL
U202: LTC6242; LT_DFN16_QUAD
U301: AK4621; AK4621_VSOP30
U401: TPA6130A2RTJR; TPA8130A2-QFN20
U501: K20X7_QFP64; FREESCALE_QFP64
U601: LP2992AILD-5.0; TI_WSON6
VAL: OSHW
X501: XTAL; TXC_7A

Connections:
+3V: C503.2, C504.2, C506.2, C507.2, C508.2, C509.2, J501.5, R501.2, R502.2, R503.2, SB301.2, U301.25, U501.3, U501.7, U501.13, U501.14, U501.21, U501.30, U501.48
+5V: C501.2, C502.2, C610.1, C611.1, FB601.2, U301.24, U501.8
+5VA: C212.1, C213.1, C214.1, C215.1, C218.1, C219.1, C301.2, C302.2, C405.2, C407.2, C605.1, C606.1, C607.1, C608.1, C609.1, FB601.1, Q201.C, Q202.C, R101.2, R201.2, R214.2, R218.2, U201.Vdd, U202.Vdd, U301.6, U301.8, U401.12, U401.20, U601.6
/Audio In/EXT_IN: C217.1, J102.2
/Audio In/MIC_IN: J101.2, R101.1, R201.1, R202.1, SB201.2
/CODEC/AINL+: C222.1, R228.2, U301.4
/CODEC/AINL-: C222.2, R227.2, U301.5
/CODEC/AINR+: C223.1, R218.1, R219.2, R222.1, U301.2
/CODEC/AINR-: C223.2, R229.2, U301.3
/CODEC/AOUTL+: C401.1, U301.28
/CODEC/AOUTL-: C403.1, U301.27
/CODEC/AOUTR+: C404.1, U301.30
/CODEC/AOUTR-: C402.1, U301.29
/CODEC/BICK: U301.12, U501.46
/HP Amp/HPL: J104.1, U401.14
/HP Amp/HPR: J105.1, U401.11
/Microcontroller/CODEC_LRCK: U301.11, U501.45
/Microcontroller/CODEC_MCLK: U301.10, U501.51
/Microcontroller/CODEC_PDN: U301.21, U501.43
/Microcontroller/CODEC_SDIN: U301.13, U501.50
/Microcontroller/CODEC_SDO: U301.14, U501.44
/Microcontroller/HP_~SD: U401.6, U501.37
/Microcontroller/I2C0_SCL: R503.1, U401.8, U501.35
/Microcontroller/I2C0_SDA: R502.1, U401.7, U501.36
/Microcontroller/PGA0_D+: J106.1, U501.9
/Microcontroller/PGA0_D-: J106.2, U501.10
/Microcontroller/RESET: C505.1, J501.1, R501.1, U501.34
/Microcontroller/SPI1_CS_CODEC: U301.19, U501.57
/Microcontroller/SPI1_SCK: U301.18, U501.58
/Microcontroller/SPI1_SOUT: U301.17, U501.59
/Microcontroller/SWCLK: J501.4, U501.22
/Microcontroller/SWDIO: J501.2, U501.25
/Microcontroller/SWO: J501.3, U501.24
/Microcontroller/UART0_RX: J103.2, U501.63
/Microcontroller/UART0_TX: J103.1, U501.64
/Microcontroller/USB_D+: J107.3, U501.5
/Microcontroller/USB_D-: J107.2, U501.6
AGND_IN: C201.1, C202.1, C204.2, C206.2, C207.2, C209.2, C211.2, C212.2, C213.2, C214.2, C215.2, C218.2, C219.2, C221.2, C301.1, C302.1, C303.1, C304.1, C405.1, C407.1, C408.1, C501.1, C502.1, C503.1, C504.1, C505.2, C506.1, C507.1, C508.1, C509.1, C510.2, C511.2, C512.1, C601.1, C602.1, C603.1, C604.1, C605.2, C606.2, C607.2, C608.2, C609.2, C610.2, C611.2, D501.2, J101.1, J102.1, J104.2, J105.2, J107.5, J501.6, J601.1, R203.1, R205.1, R215.1, R219.1, R506.1, SB301.3, U201.Vss, U202.Vss, U301.7, U301.9, U301.22, U301.23, U301.26, U401.3, U401.9, U401.10, U401.13, U401.19, U401.PAD, U501.4, U501.15, U501.16, U501.17, U501.31, U501.47, U601.2, U601.PAD
unnamed: J107.1, TP101.1
unnamed: J107.4, TP102.1
unnamed: R224.2, R225.1, U202.n3
unnamed: R225.2, R228.1, U202.o3
unnamed: C216.2, R221.2, U202.p2
unnamed: C208.2, R217.2, U202.p1
unnamed: C220.1, R220.2, R221.1
unnamed: R209.2, U201.p2
unnamed: C204.1, R207.1
unnamed: Q202.B, R204.2
unnamed: Q201.B, R202.2
unnamed: R212.1, R213.2, R216.1
unnamed: R207.2, R210.1, U201.n2
unnamed: R210.2, R213.1, U201.o2
unnamed: C201.2, Q201.E, R203.2, R204.1, SB201.1
unnamed: C202.2, C203.1, Q202.E, R205.2
unnamed: C220.2, R224.1, R227.1, U202.n2, U202.o2
unnamed: C210.1, R216.2, R217.1
unnamed: C210.2, R220.1, U202.n1, U202.o1
unnamed: C203.2, R206.2, R208.1, R209.1, SB201.3
unnamed: R226.2, R229.1, U202.o4
unnamed: C217.2, R222.2, U202.p4
unnamed: C221.1, R223.1
unnamed: R223.2, R226.1, U202.n4
unnamed: C205.2, R211.2, R212.2, U201.o1
unnamed: C205.1, R208.2, R211.1, U201.n1
unnamed: C303.2, C304.2, U301.1
unnamed: SB301.1, U301.20
unnamed: C403.2, U401.5
unnamed: C406.1, U401.18
unnamed: C406.2, U401.17
unnamed: C404.2, U401.2
unnamed: C402.2, U401.1
unnamed: C401.2, U401.4
unnamed: C408.2, U401.15, U401.16
unnamed: TP502.1, U501.39
unnamed: TP503.1, U501.1
unnamed: TP501.1, U501.40
unnamed: R504.2, U501.42
unnamed: C512.2, R505.1, R506.2, U501.38
unnamed: C510.1, U501.32, X501.2
unnamed: C511.1, U501.33, X501.1
unnamed: D501.1, R504.1
unnamed: C604.2, U601.1
unnamed: R601.2, TP601.1, U601.3
VCC: C601.2, C602.2, C603.2, J601.2, R505.2, R601.1, U601.4
VCOM_VRT: C206.1, C207.1, C208.1, C209.1, C211.1, C216.1, R206.1, R214.1, R215.2, U201.p1, U202.p3
