bnahill/audiopulse-embedded/fw_rev4/ap.ioc

Mcu.UserName=STM32H753VITx
PA3.Signal=USB_OTG_HS_ULPI_D0
PA4.Signal=USB_OTG_HS_SOF
PA5.Signal=USB_OTG_HS_ULPI_CK
PB0.Signal=USB_OTG_HS_ULPI_D1
PB1.Signal=USB_OTG_HS_ULPI_D2
PB10.Signal=USB_OTG_HS_ULPI_D3
PB11.Signal=USB_OTG_HS_ULPI_D4
PB12.Signal=USB_OTG_HS_ULPI_D5
PB13.Signal=USB_OTG_HS_ULPI_D6
PB15.Signal=GPIO_Output
PB5.Signal=USB_OTG_HS_ULPI_D7
PB6.Signal=GPIO_Output
PB7.Signal=GPIO_Output
PC0.Signal=USB_OTG_HS_ULPI_STP
PC13.Signal=GPIO_Output
PC2_C.Signal=USB_OTG_HS_ULPI_DIR
PC3_C.Signal=USB_OTG_HS_ULPI_NXT
PC9.Signal=I2S_CKIN
PD12.Signal=I2C4_SCL
PD13.Signal=I2C4_SDA
PD8.Signal=USART3_TX
PD9.Signal=USART3_RX
PE0.Signal=GPIO_Output
PE1.Signal=GPIO_Output
PE3.Signal=SAI1_SD_B
PE4.Signal=SAI1_FS_A
PE5.Signal=SAI1_SCK_A
PE6.Signal=SAI1_SD_A
