bnahill/audiopulse-embedded/(commit log)

2013-10-01 Design for preamp and output complete in kicad -- now to do uC interface
    [audio_iface_rev1.sch, audio_in.sch, codec.sch, hp_amp.sch, micro.sch]
2013-10-03 Migrated to Kinetis K20, wired up controls for CODEC
    [audio_iface_rev1.sch, audio_in.sch, codec.sch, hp_amp.sch, micro.sch]
2013-10-03 Started to specify components
    [audio_in.sch]
2013-10-04 Specified component values, beefed up simulation to match design
    [audio_iface_rev1.sch, audio_in.sch, codec.sch, hp_amp.sch, micro.sch]
2013-10-04 Made footprint for micro and amps
2013-10-04 Better supply isolation and added regulator
    [audio_iface_rev1.sch, audio_in.sch, codec.sch, hp_amp.sch, micro.sch]
2013-10-04 Added docs for regulator and uC mechanical drawings
2013-10-04 Forgot to add power schematic!
    [power.sch]
2013-10-06 Added footprints for just about everything else. Also added some comments to the schematic.
    [audio_iface_rev1.sch, audio_in.sch, codec.sch, hp_amp.sch, micro.sch, power.sch]
2013-10-07 Added some connector and solderbridge footprints
2013-10-07 Annotate components, associate footprints, and begin component placement
    [audio_iface_rev1.kicad_pcb, audio_iface_rev1.sch, audio_in.sch, codec.sch, hp_amp.sch, micro.sch, power.sch]
2013-10-07 More routing
    [audio_iface_rev1.kicad_pcb]
2013-10-08 Added a bunch of 3D models
    [audio_iface_rev1.kicad_pcb]
2013-10-12 Completed PCB with new K20x72 instead.
    [audio_iface_rev1.kicad_pcb, audio_iface_rev1.sch, audio_in.sch, codec.sch, hp_amp.sch, micro.sch, power.sch]
2013-10-14 Added supply voltage ADC input to monitor battery levels
    [audio_iface_rev1.kicad_pcb, audio_iface_rev1.sch, audio_in.sch, codec.sch, hp_amp.sch, micro.sch, power.sch]
2013-10-15 Rev1a submitted -- Moved silkscreens around
    [audio_iface_rev1-B_Cu.gbl, audio_iface_rev1-B_Mask.gbs, audio_iface_rev1-B_SilkS.gbo, audio_iface_rev1-Edge_Cuts.gbr, audio_iface_rev1-F_Cu.gtl, audio_iface_rev1-F_Mask.gts, audio_iface_rev1-F_SilkS.gto, audio_iface_rev1.drl]
2013-11-24 Added SPI driver for codec, still not getting an I2S response
2013-11-29 Started switch to HID interface
2013-11-30 Fixed issue where chip would only boot with debugger I was writing wrong register address while disabling watchdog... Now USB starts on its own
    [clocks.cpp, clocks.h]
2013-11-30 Small cleanup for initialization of LED and some docs
2013-12-04 At least SPI works right... CODEC still not outputting right
2013-12-17 CODEC responds correctly now
    [codec.cpp]
2013-12-19 Start work on making HID interface work correctly
    [user_config.h]
2013-12-25 63B control writes and 64B control reads work fine Interrupt transfers still not working, but might just use this...
    [main.cpp, user_config.h]
2013-12-29 Added math and timer libraries and tone generator
2013-12-30 Added driver for TPA6130A2
2014-01-03 Improved a lot of the math function Now more correct and robust Also power outputs are now in Q1.30 for safety
2014-01-03 More math fixes, more controller
    [controller.h]
2014-01-05 Fixed blatant hard fault in power averaging function
2014-01-07 Fixed up some broken math again, added a 'ready' flag to interface
    [controller.cpp, controller.h]
2014-01-09 Huge controller updates: Moved to more explicit state machine implementation Added control for switching HP amp as needed Timer is still broken
    [Main.java, clocks.cpp, clocks.h, controller.cpp, controller.h]
2014-01-09 Switched over to using PIT instead of FTM -- untested Also actually switched to new clock config mechanism
2014-01-09 Made it so that subsystems transition to DONE state Also LED indicates running test
2014-01-10 Test works somewhat: Tone generation and timing is great Test starts and finishes correctly and can perform multiple tests in sequence. DSP seems okay but there is definitely some error in there. I t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
    [Main.java, controller.cpp, controller.h, main.cpp]
2014-01-11 Fixed transform output problems which cause negative power The problem was that the constants 1/n and 1-1/n were being generated incorrectly; fixed sFractional::mk_frac
    [main.cpp]
2014-01-11 Transform output format and order fixed and able to send data to android
    [controller.cpp]
2014-01-14 Small changes to accommodate calibration
2014-01-19 Changed to linear interpolation for speaker calibration and... Also enable LED on start Also use larger integer component for PSD
2014-01-28 Added basic 16-band online calibration for input
2014-02-01 Reset on USB enumeration
    [controller.cpp, controller.h]
2014-02-02 Changed to higher-order decimation filter
2014-02-02 Added calibration to Python UI
2014-02-04 Small fixes to UI
    [apulse_ui.py]
2014-02-10 Tiny UI fixes for overlap and text
    [apulse_iface.py, apulse_ui.py]
2014-02-18 Firmware sample subtraction works. Now for stationary noise subtraction
    [codec.cpp, controller.cpp, controller.h]
2014-04-16 Fixed FIR order initialized to arbitrary "5"
    [apulse_ui.py]
2014-04-22 Started rev2a design based on rev1a
    [audio_iface_rev2.sch, audio_in.sch, codec.sch, hp_amp.sch, micro.sch, power.sch]
2014-05-03 Lots of things: --Added RGB LED on timer outputs --Input: Moved capacitively coupled feedback nodes from vgnd to gnd --Output: LTC6242 for filtering to amplifier --Power: 2-stage supply for analog: U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
    [audio_iface_rev2.sch, audio_in.sch, codec.sch, hp_amp.sch, micro.sch, power.sch]
2014-05-06 ACTUALLY ADDED THE PCB THIS TIME... A few more changes Added dimensions and some decorative silks Also got rid of reference silks for most passives and reorganized the rest. TODO: Add pads for that s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
    [audio_iface_rev2.kicad_pcb]
2014-05-07 Added extra oscillator JIC. Moved labels and made it pretty. Also fixed a missing capacitron
    [audio_iface_rev2.kicad_pcb, audio_iface_rev2.sch, audio_in.sch, codec.sch, hp_amp.sch, micro.sch, power.sch]
2014-05-08 rev2a finalized
    [audio_iface_rev2.kicad_pcb]
2014-05-08 Added submitted gerbers for rev2a
    [audio_iface_rev2-B_Cu.gbl, audio_iface_rev2-B_Mask.gbs, audio_iface_rev2-B_SilkS.gbo, audio_iface_rev2-Edge_Cuts.gbr, audio_iface_rev2-F_Cu.gtl, audio_iface_rev2-F_Mask.gts, audio_iface_rev2-F_SilkS.gto, audio_iface_rev2-NPTH.drl]
2014-05-28 Updated firmware sources to match rev2a Power supply reset architecture now built into test coordination Analog domain components now have split initialization *All untested*
    [codec.cpp, controller.cpp, controller.h, main.cpp]
2014-06-29 Rev 2a sent off for manufacturing: Slot added instead of drill hole at audio IO end Drill added near center Fixed huge error in HP amp schematic/layout Got rid of more labels Got rid of redundant UAR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
    [audio_iface_rev2-B_Cu.gbl, audio_iface_rev2-B_Mask.gbs, audio_iface_rev2-B_SilkS.gbo, audio_iface_rev2-Edge_Cuts.gbr, audio_iface_rev2-F_Cu.gtl, audio_iface_rev2-F_Mask.gts, audio_iface_rev2-F_SilkS.gto, audio_iface_rev2.drl]
2014-07-26 Fixed so it will compile in 32k of RAM TODO: Figure out why switching to packaged GCC 4.9.1 increased RAM usage
    [controller.cpp]
2014-08-15 Firmware: Fixed buffer iterator problem that was causing massive distortion UI: More reliable waveform dumps
    [apulse_iface.py, apulse_ui.py, controller.h]
2014-08-18 Added forgotten PWM GPIO sources
2014-08-30 Added filter design script for shift to IIR cascade Requires scipy, numpy, and matplotlib(for plots)
2014-08-30 Fixed some things with the filter designer: Fixed bug in quantization Added plotting of quantized frequency response Added different infinity and first-only gain distributions TODO!: Actual rounding 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
2014-08-31 Filter design got a bit more stuff: Rounding instead of truncation Quantized plot uses sections (correct transfer function!)
2014-08-31 Switched to IIR for decimation -- NOTE: This is untested. I switched it on a train...
2014-08-31 Cosmetic improvements to filter designer
2014-09-10 Added options to switch between IIR and FIR (because IIR is broken now)
2014-09-23 Minimal framework for bounds checking added Nothing done with it
2014-10-03 Minor change to abstract power control at Platform level
2014-10-17 Added values for LED resistors
    [micro.sch]
2014-11-28 "added option to generate stimulus frequency at an approximate frequency from the original that will minimize FFT leakage due to sample size"
2014-11-28 added decimation stage to the analysis
2014-12-22 Added fixes again to at least enumerate on USB and almost do tests
    [clocks.cpp, clocks.h, codec.cpp, controller.cpp, controller.h, main.cpp]
2015-01-04 Modified HW interface and DSP toward a 1024-long FP chain
2015-01-12 Fancier debug plotting, switched to external MCLK
2015-02-12 Added fancy adapter board to SMA connectors
    [sma_adapter.kicad_pcb, sma_adapter.sch]
2015-02-12 Fixed bug with audio interface. It was dumb.
    [codec.cpp]
2015-04-22 Fixed to run correctly with FPU
    [codec.cpp, main.cpp]
2015-05-12 Added serial flash module to schematic and began layout
    [audio_iface_rev2.kicad_pcb, audio_iface_rev2.sch, audio_in.sch, codec.sch, hp_amp.sch, micro.sch, power.sch]
2015-05-13 Forgot to add Micron BGA footprint
2015-05-13 Added SMA connectors, still need to recreate keepouts
    [audio_iface_rev2.kicad_pcb, audio_iface_rev2.sch, audio_in.sch, codec.sch, hp_amp.sch, micro.sch, power.sch]
2015-06-01 Updated layout to what was submitted for rev3a
    [audio_iface_rev2-B_Cu.gbl, audio_iface_rev2-B_Mask.gbs, audio_iface_rev2-B_SilkS.gbo, audio_iface_rev2-Edge_Cuts.gbr, audio_iface_rev2-F_Cu.gtl, audio_iface_rev2-F_Mask.gts, audio_iface_rev2-F_SilkS.gto, audio_iface_rev2-NPTH.drl]
2015-06-09 Fixed some of it
    [codec.cpp]
2015-07-07 Made codec not a static class; also added switch for power always on
2015-07-15 LOTS: Added Flash, converted SPI and codec away from static classes
2015-08-02 Fixed codec initialization to reliably preserve the same channel mapping
    [codec.cpp, controller.cpp]
2015-10-08 Added SysTick handling for an easier-to-use timer
2015-11-03 Cleaned up tone generation that I thought I fixed last time--also sped up input sample conversion. Output now capped at 80dB
2016-03-27 Added UART driver, yet untested This shouldn't break anything though...
2016-04-01 Started using the UART driver, still debugging
2016-04-02 Made some really minor changes to UART driver
2016-09-20 Started board upgrade to 4 layers and better signal isolation
    [audio_iface_rev2.kicad_pcb, audio_iface_rev2.sch, audio_in.sch, codec.sch, hp_amp.sch, micro.sch, power.sch]
2016-09-28 Routed out 4-layer variant--now need to do silkscreens and such
    [audio_iface_rev2.kicad_pcb, audio_iface_rev2.sch, micro.sch, power.sch]
2016-09-30 Submitted PCB revision
    [audio_iface_rev2.kicad_pcb, audio_iface_rev2.sch, audio_in.sch, codec.sch, hp_amp.sch, micro.sch, power.sch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]
2016-10-23 C++11 compatibility fix:
    More recent versions of gcc started enforcing constexpr restrictions
    for allowing reinterpret_cast to be constant. This makes it impossible
    to use peripheral addresses by pointer in constexpr initialization...
    The solution has been to add the references in the linker instead,
    making peripherals into actual objects.
    Results yet untested.
    [clocks.h, gpio.h, main.cpp]
2016-11-01 Neatened up LED stuff--about to rip apart DSP
2016-11-08 Accumulate in abs(transform) rather than power. Also...
    Output levels pushed to sane values (within 5dB of accurate)
2019-01-28 Most of a schematic
    [audio_iface_rev2.kicad_pcb, audio_iface_rev2.sch, audio_in.sch, codec.sch, hp_amp.sch, micro.sch, power.sch]
2019-02-03 Schematic roughly complete
    [audio_iface_rev2.kicad_pcb, audio_iface_rev2.sch, micro.sch, power.sch]
2019-09-17 Added teensy library, fixed footprint and lib paths
2019-09-17 Much more routing
    [audio_iface_rev2.kicad_pcb, audio_iface_rev2.sch, micro.sch, power.sch]
2019-09-25 Design nearly complete. One more check.
    [audio_iface_rev2.kicad_pcb, audio_iface_rev2.sch, micro.sch, power.sch]
2019-10-14 Changed some connectors, added files
    [audio_iface_rev2.kicad_pcb, audio_iface_rev2.sch]
2019-11-04 Added software for new board rev
2020-01-09 Some half-hearted structure and driver code written on the plane
